KakiArduino/INA282-ADS1115/README.md

# INA282-ADS1115
Bidirectional current measurement system using the INA282 current-sense amplifier module, interfaced with the ADS1115 analog-to-digital converter (ADC) module, and controlled by an Arduino platform.
