KakiArduino/INA282-ADS1115/INA282_Ads1115_ver3.docx

Arduino ADS1115 INA282

Here, a current measurement system is proposed using the INA282 current-sense amplifier module [1], interfaced with the ADS1115 analog-to-digital converter (ADC) module [2, 3, 4], and controlled by an Arduino platform [5]. This configuration was selected due to the accessibility, low cost, and ease of integration of the main components.

The INA282 enables high-side or low-side current sensing, allowing current measurements with common-mode voltages ranging from –14 V to +80 V relative to ground. Detailed application information can be found in the Texas Instruments product documentation [6].

In this project, bidirectional current measurement was implemented by applying a 5.0 V reference offset to the INA282 REF1 and REF2 terminals. Under this configuration, a zero-current condition corresponds to an INA282 output voltage of 5.0 V. For positive currents, the output voltage varies between 5.0 V and 10.0 V, whereas for negative currents, it varies between 5.0 V and 0.0 V. This output range is monitored by the ADS1115 configured in differential input mode, where the same 5.0 V reference offset applied to the INA282 is also connected to the AinN input of the ADS1115, establishing a common reference potential.

### Simplified Version

In the simplified configuration, the TL431 precision shunt regulator is used as the reference voltage source, providing a stable 2.5 V reference. This voltage is filtered by a 100 Ω resistor and a 10 µF SMD ceramic capacitor to reduce noise and improve stability. The filtered reference voltage is then applied directly to the A1 (AinN) input of the ADS1115.

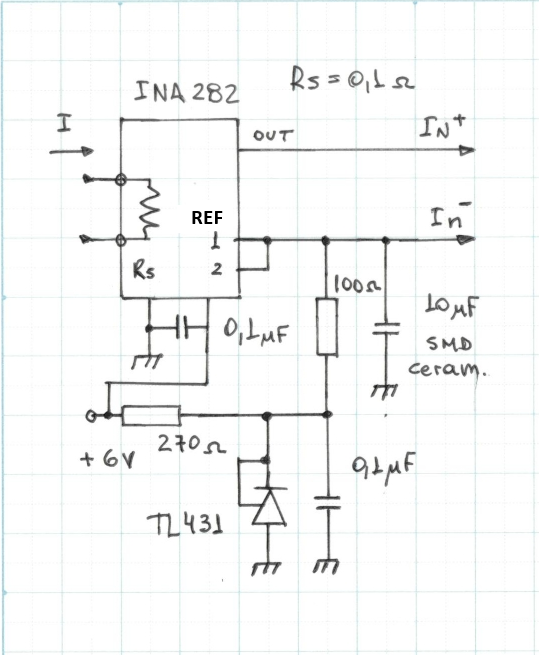
[picture p1: figure]

### Low-Noise Version

In the low-noise configuration, the TL431 is arranged to generate a 5.0 V reference voltage by means of a voltage multiplication circuit formed by two 10 kΩ resistors. A BF245C JFET transistor is configured as a 10 mA constant current source to improve TL431 bias stability and reduce reference voltage fluctuations; alternatively, the BF245C may be replaced by a 470 Ω resistor. Additional capacitors are included to enhance noise suppression. The generated 5.0 V reference is filtered through a 100 Ω resistor and a 10 µF SMD ceramic capacitor. This filtered voltage is then connected to the A1 (AinN) input of the ADS1115 through a 2:1 voltage divider composed of two 10 kΩ resistors. Similarly, the output of the INA282 module, which ranges from approximately 1.0 V to 9.0 V* under normal operating conditions, is connected to the A0 (AinP) input of the ADS1115 through another 2:1 voltage divider formed by two 10 kΩ resistors. The analog input filtering stage of the ADS1115 consists of two 68 Ω resistors, two 10 nF capacitors, and one 100 nF capacitor, which together provide attenuation of high-frequency noise and improve conversion stability.*This range corresponds to the practical measurement limits of the ADS1115 input stage, although the INA282 output itself may vary from 0 V to 10 V.

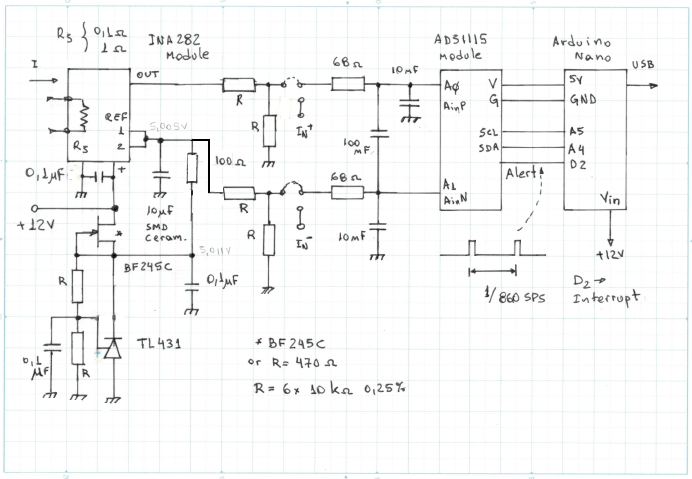
[picture p2: figure]

The ADS1115 communicates with the Arduino Nano through the I2C interface. Additionally, the ALERT pin of the ADS1115 is connected to the D2 pin of the Arduino, which can be configured as an external interrupt input. The ADS1115 can be programmed to generate a positive pulse at the end of each analog-to-digital conversion, enabling interrupt-driven acquisition. This feature is particularly useful when operating at the maximum conversion rate of 860 SPS (samples per second).

The measurement range can be adjusted by replacing the current-sense resistor (RS, shunt resistor), which is typically supplied as 0.1 Ω. The ADS1115 is configured with a full-scale differential input range of ±2048 mV, while the INA282 provides a fixed voltage gain of 50 V/V. Consequently, the maximum voltage across the shunt resistor is limited to approximately 40 mV. The maximum measurable current is therefore determined by:

Imax= 40 mV / Rs

For the standard 0.1 Ω shunt resistor, the resulting measurement range is approximately ±400 mA in the simplified version and ±800 mA in the low-noise version.

[1] https://wolles-elektronikkiste.de/en/ina282-current-sensor

[2] https://www.seeedstudio.com/blog/2020/09/30/analog-to-digital-converter-ads1115/

[3] https://wolles-elektronikkiste.de/en/current-sensor-how-to-build-it-yourself

[4] https://wiki.seeedstudio.com/Grove-16-bit-ADC-ADS1115/

[5] https://www.arduino.cc/

[6] https://www.ti.com/product/INA282
